bluebrother/ir-remote/(commit log)

2011-05-24 Initial schematic for remote receiver.
    First version for a IR receiver targetted at working with the Iriver H100 /
    H300 audio players. It emulates the original wired remote. Decoding the IR
    signal is done via an ATtiny2313.
    Issues: The player doesn't power up with this circuit connected, disconnect for
    power up.
    [ir-remote.sch]
2011-05-28 Initial controller firmware.
    This implements receiving the infrared RC5 signal and decodes it, then toggles
    the appropriate GPIO pins to output the correct levels to the player. A delay
    mechanism has been implemented to give the output the necessary minimum time to
    get recognized by the player.
    This code assumes an updated circuit to fix the power on issue. Verified with a
    player running Rockbox, the Iriver firmware might need some timing adjustments.
    [main.c, rc5.c, rc5.h]
2011-05-28 Update schematic with reworked Start button.
    Connect the Start button via a universal transistor instead of connecting it
    directly to the controller. Fixes the player not turning on when the receiver
    is connected (caused by the player still providing a voltage to the receiver).
    [ir-remote.sch]
2011-06-11 Change ISP connector name and add project URL to schematic.
    [ir-remote.sch]
2011-07-20 Document fuse settings.
